RobOneJan/terbox-cad-backend/README.md

# terbox-cad-backend
used for terbox configurator to display live cad config and create bom later
