RobOneJan/terbox-cad-backend/AN-1000 (1).pdf

## Kopie Angebot AN-1000

Sehr geehrte Damen und Herren,
vielen Dank für Ihre Anfrage. Gerne unterbreiten wir Ihnen das gewünschte freibleibende Angebot:
Pos. Beschreibung | Menge | Einzelpreis | Gesamtpreis
1. Grundkorpus
3,60 m lang, 2,00 m tief, 2,20 m hoch verzinkter Stahl, RAL 7016 anthrazit grau beschichtet inklusive Dach und Dachrinne | 1,00 Stk | 3.060,00 EUR | 3.060,00 EUR
2. WPC Holzoptik
Farbe Teak
2 Wände 1,80 x 2,00 m
2 Wände 1,60 x 2,00 m
1,00 Stk | 1.320,00 EUR | 1.320,00 EUR
3. Fahrradbügel
zum Abschließen der Fahrräder
verzinkter Stahl, RAL 7016 anthrazit grau beschichtet
1,00 Stk | 290,00 EUR | 290,00 EUR
4. | Außensteckdosen zum Aufladen für E-Bikes | 5,00 Stk | 20,00 EUR | 100,00 EUR
5. LED Lichter
| inklusive | 1,00 Stk | 150,00 EUR | 150,00 EUR
6. | Dachbegrünung | 1,00 Stk | 250,00 EUR | 250,00 EUR
7. | Lieferkosten | 1,00 Stk | 100,00 EUR | 100,00 EUR

TER-BOX - Domstraße 84 - 50668 Köln

Herrn Engelbert Schnoklake SONTEX Schutzbekleidung® e.K. Heinrich-Hertz-Straße 7
46399 Bocholt
Deutschland
Angebots-Nr. | AN-1000
Datum | 12.02.2026
Ihre Kundennummer | 1001
Ihr Ansprechpartner | Sven Terhardt

1/2
TER-BOX Inhaber Sven Terhardt Domstraße 84
50668 Köln
Deutschland

Tel. 01721041972
E-Mail sven@ter-box.com
Web www.ter-box.com

USt.-ID DE460259212
Steuer-Nr. 21551718131
Inhaber/-in Sven Terhardt

Bank Volksbank Bocholt
Konto 0228236302
BLZ 42860003
IBAN DE58 428600030228236302 BIC GENODEM1BOH

Für Rückfragen stehen wir Ihnen jederzeit gerne zur Verfügung. Wir bedanken uns sehr für Ihr Vertrauen.
Mit freundlichen Grüßen
Sven Terhardt

2/2
TER-BOX Inhaber Sven Terhardt Domstraße 84
50668 Köln
Deutschland

Tel. 01721041972
E-Mail sven@ter-box.com
Web www.ter-box.com

USt.-ID DE460259212
Steuer-Nr. 21551718131
Inhaber/-in Sven Terhardt

Bank Volksbank Bocholt
Konto 0228236302
BLZ 42860003
IBAN DE58 428600030228236302 BIC GENODEM1BOH
