RobOneJan/terbox-cad-backend/PV ST SOLAR.step

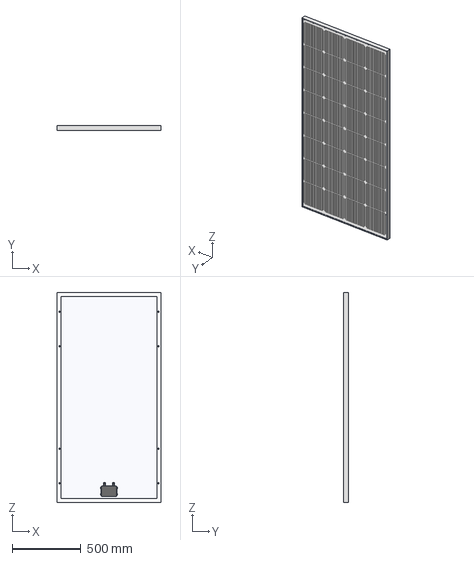
[picture p1: CAD file, 2026-06-04]
PV ST SOLAR.step
760.0 x 35.2 x 1530.0 mm
