RobOneJan/terbox-cad-backend/TER BOX 100x100.step

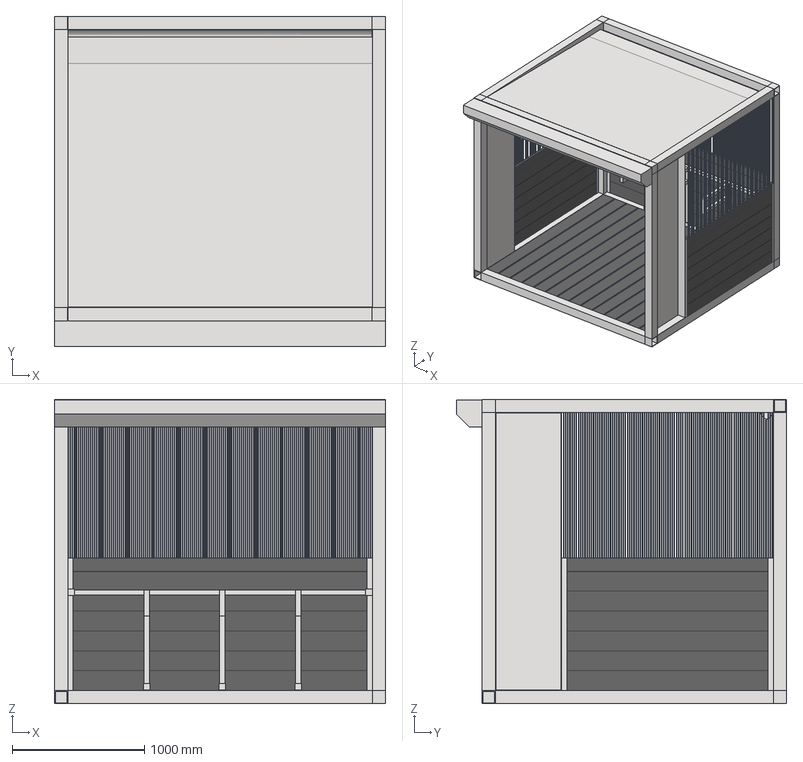
[picture p3: CAD file, 2026-05-15]
TER BOX 100x100.step
2500.2 x 2494.0 x 2300.0 mm
