RobOneJan/terbox-cad-backend/(commit log)

2026-05-15 new version
    [01_0000.step, TER BOX 100x100.step]
2026-05-25 new configurato
    [TER BOX AB1000.step]
